FBIopeningUPP/aerix-core/hardware/core/production/bom.csv

Designator | Footprint | Quantity | Value | LCSC Part #
C1, C10, C11, C12, C13, C14, C15, C2, C20, C22, C24, C27, C28, C3, C30, C31, C33, C34, C35, C36, C37, C38, C4, C40, C41, C43, C44, C46, C47, C48, C5, C6, C7, C8, C9 | 0201 | 35 | 100nF
C16, C17, C18 | 0201 | 3 | 4.7uF
C19, C21, C23, C51, C52, C53, C54, C55, C56 | 0402 | 9 | 1uF
C25, C26, C29, C32 | 0402 | 4 | 2.2uF
C42, C45 | 0402 | 2 | 4.7uF
C49 | 0603 | 1 | 10uF
C50 | 0603 | 1 | 22uF
CARD1 | TF-SMD_TF-021B-H265 | 1 | TF-021B-H265 | C498185
CN1, CN2 | CONN-SMD_DF40C-80DS-0.4V-51 | 2 | DF40C-80DS-0.4V | C312960
FB1, FB2, FB3 | 0603 | 3 | 600
LED1, LED2 | 0402 | 2 | LED_0402
R1, R2, R3, R4, R5, R6, R7 | 0201 | 7 | 10k
R10, R11, R12, R8, R9 | 0201 | 5 | 47k
R13, R14 | 0201 | 2 | 1k
U1 | UFBGA-201_10x10mm_Layout15x15_P0.65mm | 1 | STM32H743IIKx
U10, U9 | TDFN-8_L3.0-W3.0-P0.65-BL-EP | 2 | TCAN1044AVDRBRQ1 | C3234119
U11, U12, U13 | X2SON-4_L1.0-W1.0-P0.65-TL-EP | 3 | TPS7A2033PDQNR | C2871641
U14 | USIP-10_L2.5-W2.0-P0.50-BL | 1 | TPSM82822SILR | C5219367
U2 | LGA-14_L3.0-W2.5-P0.50-TL | 1 | IIM-42653 | C30724128
U3 | LGA-14_L3.0-W2.5-P0.50-TL | 1 | ICM-45686 | C22459454
U4 | LGA-16_L4.5-W3.0-P0.50-BL | 1 | BMI088 | C194919
U5 | LGA-10_L2.0-W2.0-P0.50-BL | 1 | BMP390_C5124834 | C5124834
U6 | LGA-10_L2.0-W2.0-P0.50-TL_ICP-20100 | 1 | ICP-20100 | C5343527
U7 | WSON-8-1EP_8x6mm_P1.27mm_EP3.4x4.3mm | 1 | W25Q128JVE
X1 | CRYSTAL-SMD_4P-L3.2-W2.5-BL-1 | 1 | ABM8W-16.0000MHZ-8-D1X-T3 | C193746
