FBIopeningUPP/aerix-core/hardware/core/core.kicad_pcb

## KiCad design hardware/core/core.kicad_pcb (2026-11-12)

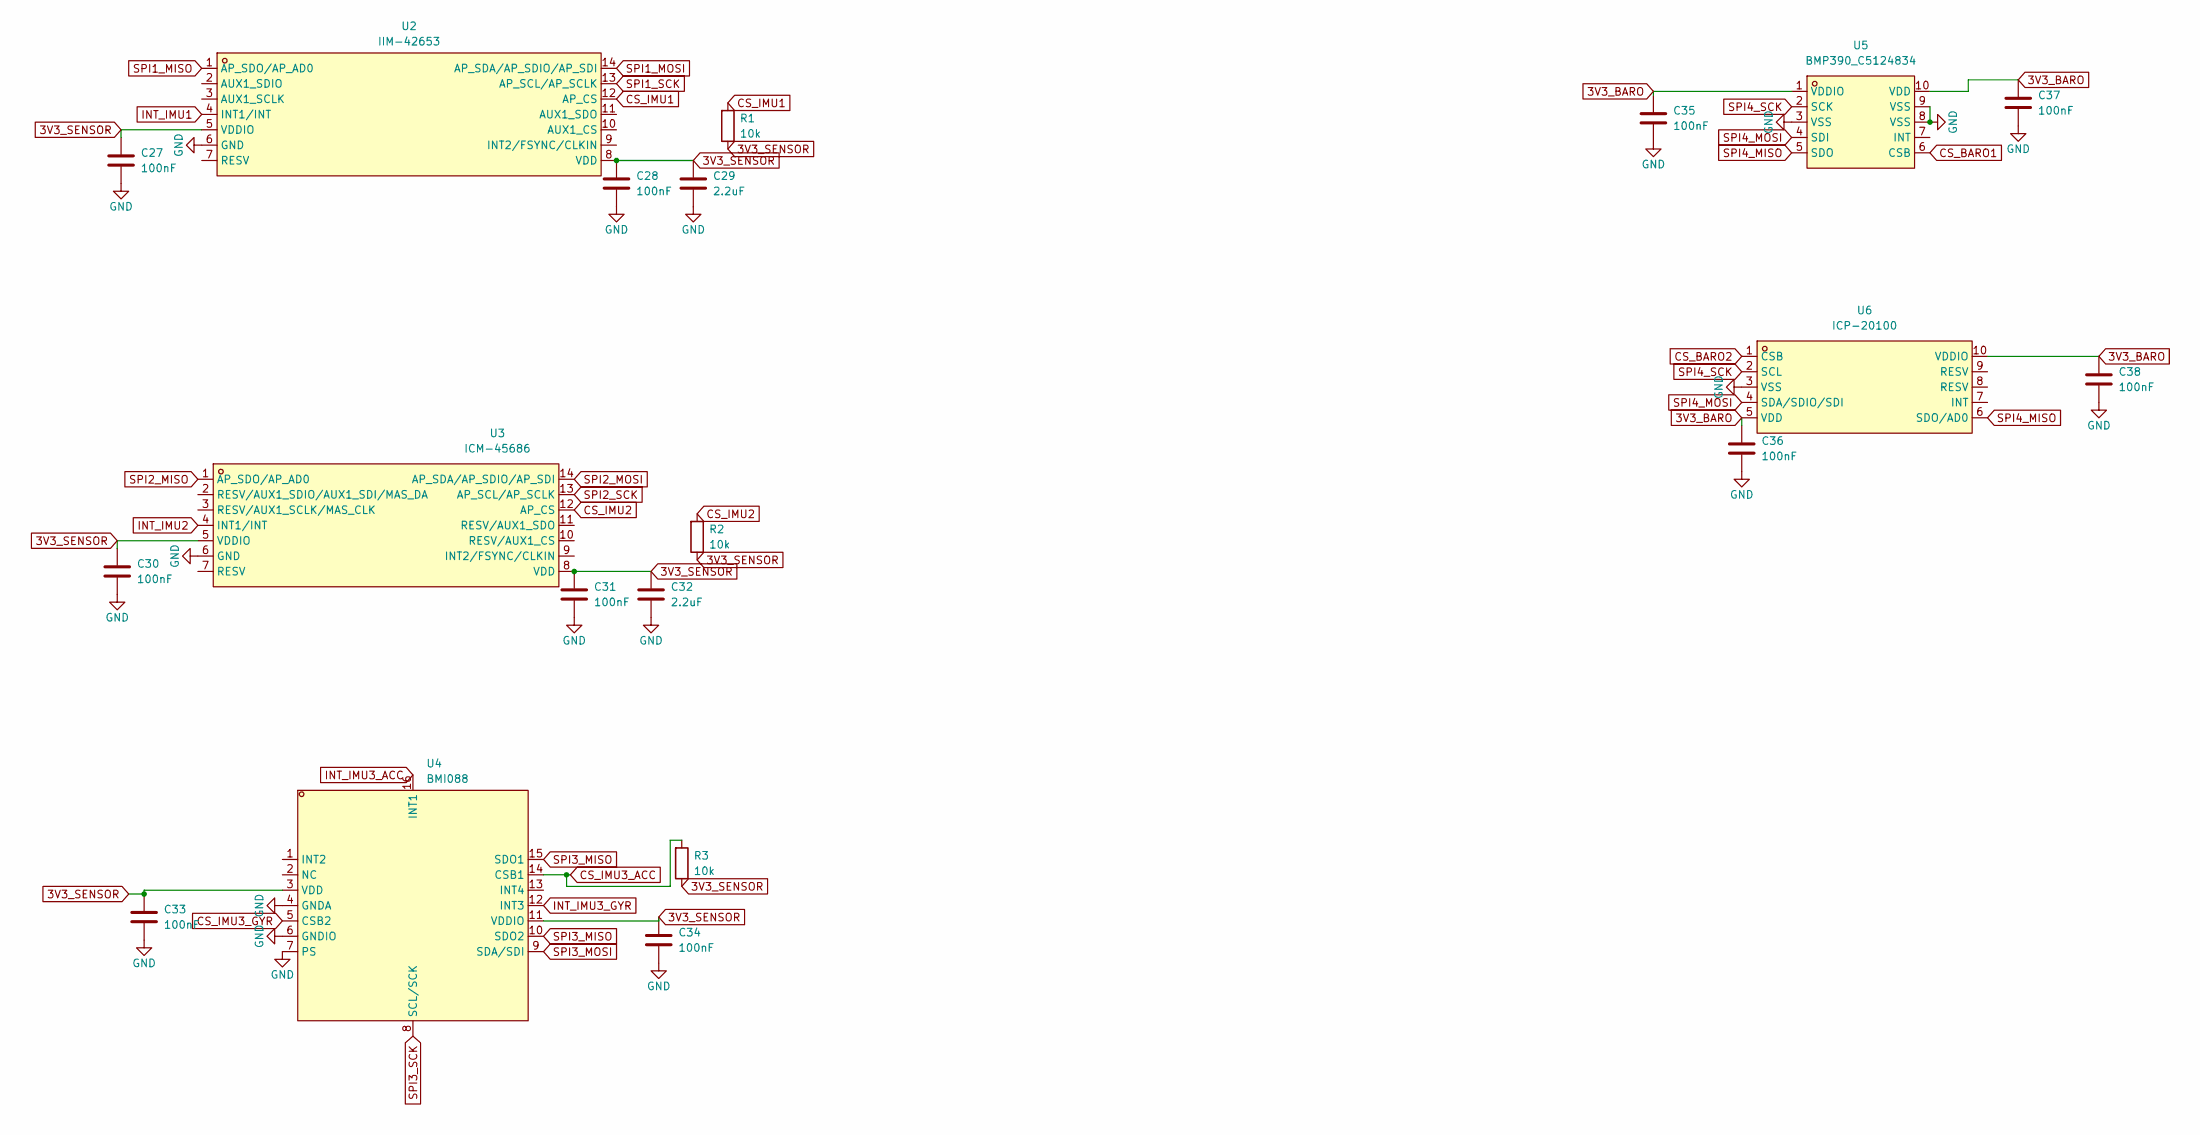
[picture p4: schematic sensor.kicad_sch]

Parts:
C27, C28, C30, C31, C33, C34, C35, C36, C37, C38: 100nF; C_0201_0603Metric
C29, C32: 2.2uF; C_0402_1005Metric
R1, R2, R3: 10k; R_0201_0603Metric
U2: IIM-42653; LGA-14_L3.0-W2.5-P0.50-TL; MPN IIM-42653; LCSC Part C30724128
U3: ICM-45686; LGA-14_L3.0-W2.5-P0.50-TL; MPN ICM-45686; LCSC Part C22459454
U4: BMI088; LGA-16_L4.5-W3.0-P0.50-BL; MPN BMI088; LCSC Part C194919
U5: BMP390_C5124834; LGA-10_L2.0-W2.0-P0.50-BL; MPN BMP390; LCSC Part C5124834
U6: ICP-20100; LGA-10_L2.0-W2.0-P0.50-TL_ICP-20100; MPN ICP-20100; LCSC Part C5343527

Connections:
3V3_BARO: C35.1, C36.1, C37.1, C38.1, U5.1 (VDDIO), U5.10 (VDD), U6.5 (VDD), U6.10 (VDDIO); also elsewhere on the board
3V3_SENSOR: C27.1, C28.1, C29.1, C30.1, C31.1, C32.1, C33.1, C34.1, R1.2, R2.2, R3.2, U2.5 (VDDIO), U2.8 (VDD), U3.5 (VDDIO), U3.8 (VDD), U4.3 (VDD), U4.11 (VDDIO); also elsewhere on the board
CS_BARO1: U5.6 (CSB); also elsewhere on the board
CS_BARO2: U6.1 (CSB); also elsewhere on the board
CS_IMU1: R1.1, U2.12 (AP_CS); also elsewhere on the board
CS_IMU2: R2.1, U3.12 (AP_CS); also elsewhere on the board
CS_IMU3_ACC: R3.1, U4.14 (CSB1); also elsewhere on the board
CS_IMU3_GYR: U4.5 (CSB2); also elsewhere on the board
GND: C27.2, C28.2, C29.2, C30.2, C31.2, C32.2, C33.2, C34.2, C35.2, C36.2, C37.2, C38.2, U2.6 (GND), U3.6 (GND), U4.4 (GNDA), U4.6 (GNDIO), U4.7 (PS), U5.3 (VSS), U5.8 (VSS), U5.9 (VSS), U6.3 (VSS); also elsewhere on the board
INT_IMU1: U2.4 (INT1/INT); also elsewhere on the board
INT_IMU2: U3.4 (INT1/INT); also elsewhere on the board
INT_IMU3_ACC: U4.16 (INT1); also elsewhere on the board
INT_IMU3_GYR: U4.12 (INT3); also elsewhere on the board
SPI1_MISO: U2.1 (AP_SDO/AP_AD0); also elsewhere on the board
SPI1_MOSI: U2.14 (AP_SDA/AP_SDIO/AP_SDI); also elsewhere on the board
SPI1_SCK: U2.13 (AP_SCL/AP_SCLK); also elsewhere on the board
SPI2_MISO: U3.1 (AP_SDO/AP_AD0); also elsewhere on the board
SPI2_MOSI: U3.14 (AP_SDA/AP_SDIO/AP_SDI); also elsewhere on the board
SPI2_SCK: U3.13 (AP_SCL/AP_SCLK); also elsewhere on the board
SPI3_MISO: U4.10 (SDO2), U4.15 (SDO1); also elsewhere on the board
SPI3_MOSI: U4.9 (SDA/SDI); also elsewhere on the board
SPI3_SCK: U4.8 (SCL/SCK); also elsewhere on the board
SPI4_MISO: U5.5 (SDO), U6.6 (SDO/AD0); also elsewhere on the board
SPI4_MOSI: U5.4 (SDI), U6.4 (SDA/SDIO/SDI); also elsewhere on the board
SPI4_SCK: U5.2 (SCK), U6.2 (SCL); also elsewhere on the board

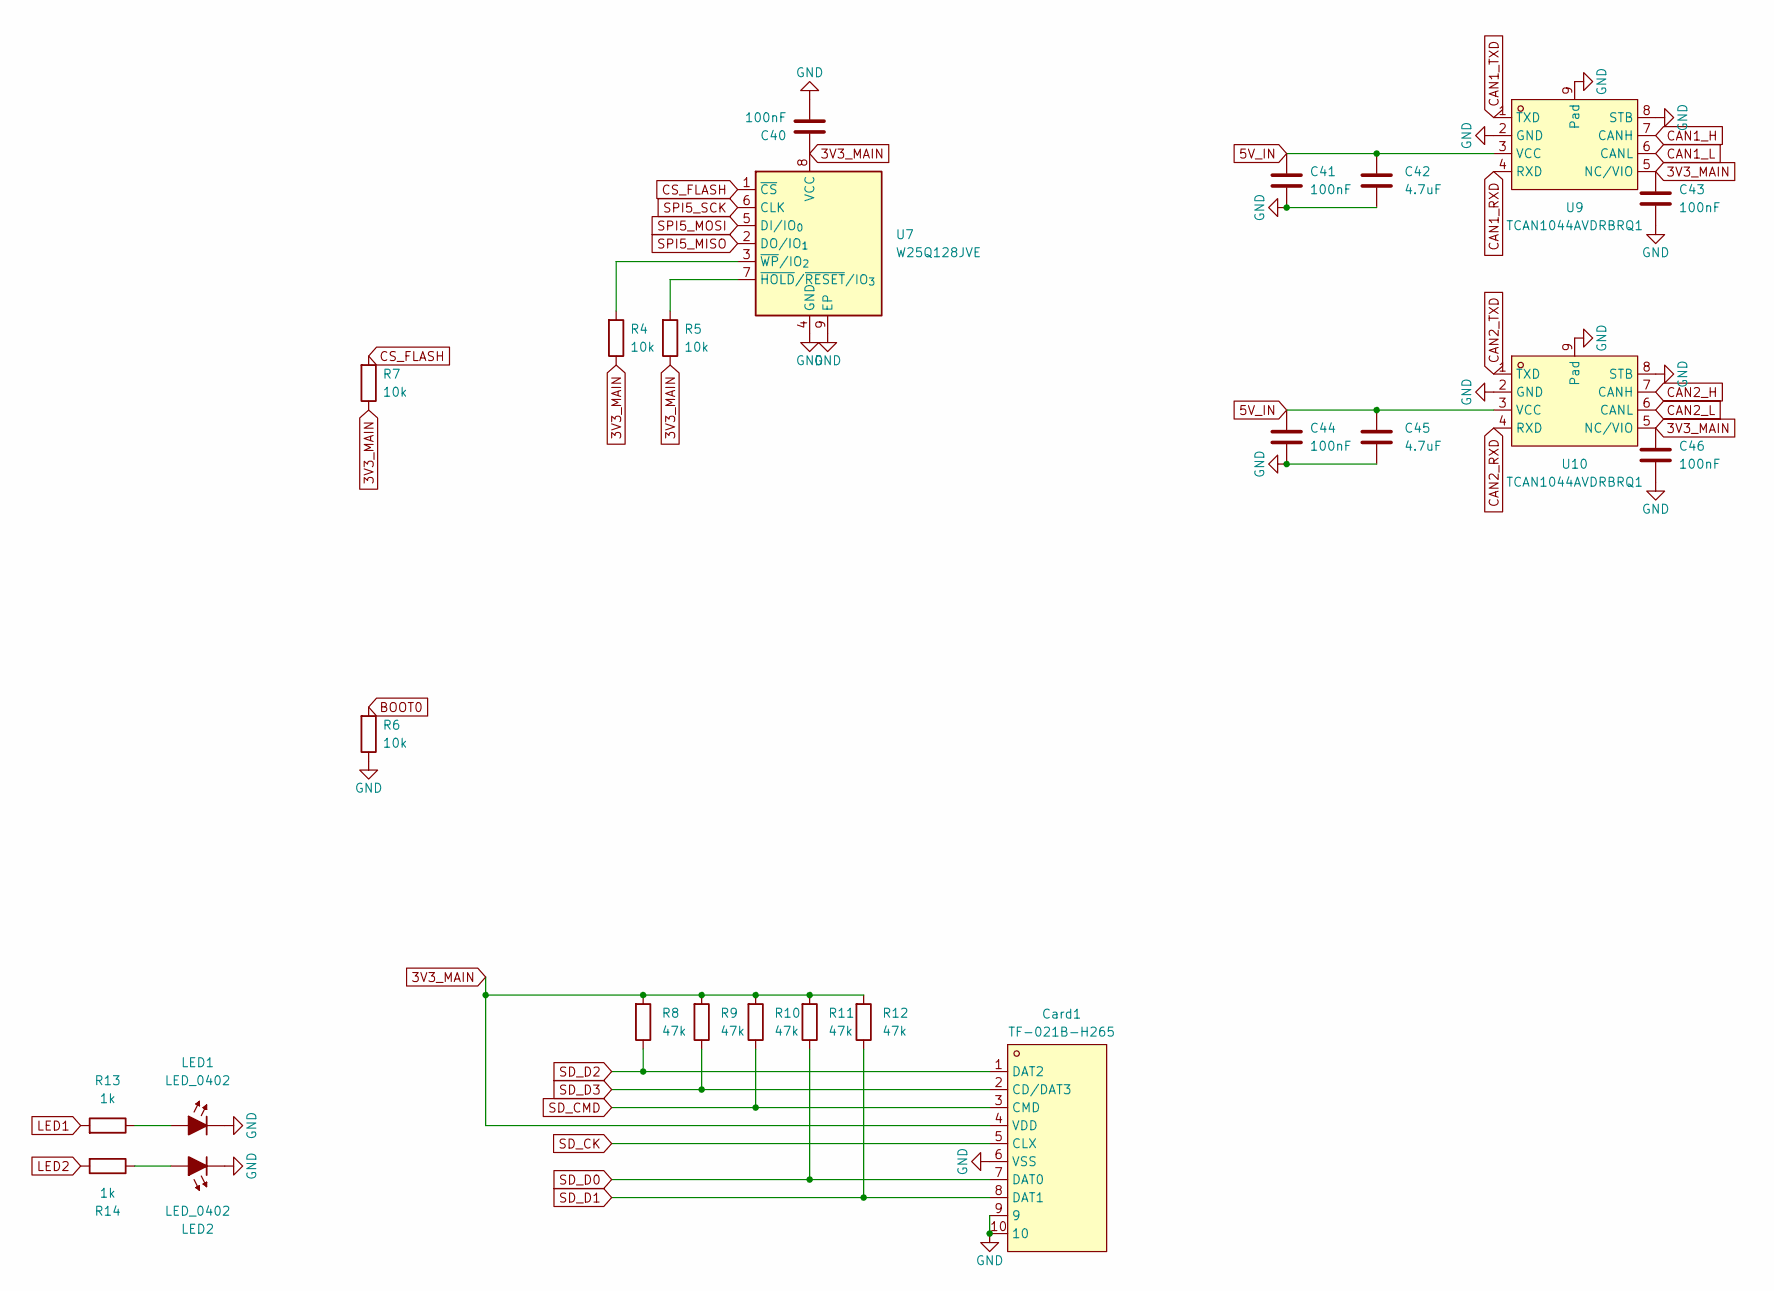
[picture p5: schematic etc.kicad_sch]

Parts:
C40, C41, C43, C44, C46: 100nF; C_0201_0603Metric
C42, C45: 4.7uF; C_0402_1005Metric
Card1: TF-021B-H265; TF-SMD_TF-021B-H265; MPN TF-021B-H265; LCSC Part C498185
LED1, LED2: LED_0402; LED_0402_1005Metric
R4, R5, R6, R7: 10k; R_0201_0603Metric
R8, R9, R10, R11, R12: 47k; R_0201_0603Metric
R13, R14: 1k; R_0201_0603Metric
U7: W25Q128JVE; WSON-8-1EP_8x6mm_P1.27mm_EP3.4x4.3mm
U9, U10: TCAN1044AVDRBRQ1; TDFN-8_L3.0-W3.0-P0.65-BL-EP; MPN TCAN1044AVDRBRQ1; LCSC Part C3234119

Connections:
3V3_MAIN: C40.1, C43.1, C46.1, Card1.4 (VDD), R4.2, R5.2, R7.2, R8.1, R9.1, R10.1, R11.1, R12.1, U7.8 (VCC), U9.5 (NC/VIO), U10.5 (NC/VIO); also elsewhere on the board
5V_IN: C41.1, C42.1, C44.1, C45.1, U9.3 (VCC), U10.3 (VCC); also elsewhere on the board
BOOT0: R6.1; also elsewhere on the board
CAN1_H: U9.7 (CANH); also elsewhere on the board
CAN1_L: U9.6 (CANL); also elsewhere on the board
CAN1_RXD: U9.4 (RXD); also elsewhere on the board
CAN1_TXD: U9.1 (TXD); also elsewhere on the board
CAN2_H: U10.7 (CANH); also elsewhere on the board
CAN2_L: U10.6 (CANL); also elsewhere on the board
CAN2_RXD: U10.4 (RXD); also elsewhere on the board
CAN2_TXD: U10.1 (TXD); also elsewhere on the board
CS_FLASH: R7.1, U7.1 (~CS); also elsewhere on the board
GND: C40.2, C41.2, C42.2, C43.2, C44.2, C45.2, C46.2, Card1.6 (VSS), Card1.9, Card1.10, LED1.1 (K), LED2.1 (K), R6.2, U7.4 (GND), U7.9 (EP), U9.2 (GND), U9.8 (STB), U9.9 (Pad), U10.2 (GND), U10.8 (STB), U10.9 (Pad); also elsewhere on the board
LED1: R13.1; also elsewhere on the board
LED2: R14.1; also elsewhere on the board
unnamed: LED1.2 (A), R13.2
unnamed: LED2.2 (A), R14.2
unnamed: R5.1, U7.7 (~HOLD/~RESET/IO_{3})
unnamed: R4.1, U7.3 (~WP/IO_{2})
SD_CK: Card1.5 (CLX); also elsewhere on the board
SD_CMD: Card1.3 (CMD), R10.2; also elsewhere on the board
SD_D0: Card1.7 (DAT0), R11.2; also elsewhere on the board
SD_D1: Card1.8 (DAT1), R12.2; also elsewhere on the board
SD_D2: Card1.1 (DAT2), R8.2; also elsewhere on the board
SD_D3: Card1.2 (CD/DAT3), R9.2; also elsewhere on the board
SPI5_MISO: U7.2 (DO/IO_{1}); also elsewhere on the board
SPI5_MOSI: U7.5 (DI/IO_{0}); also elsewhere on the board
SPI5_SCK: U7.6 (CLK); also elsewhere on the board

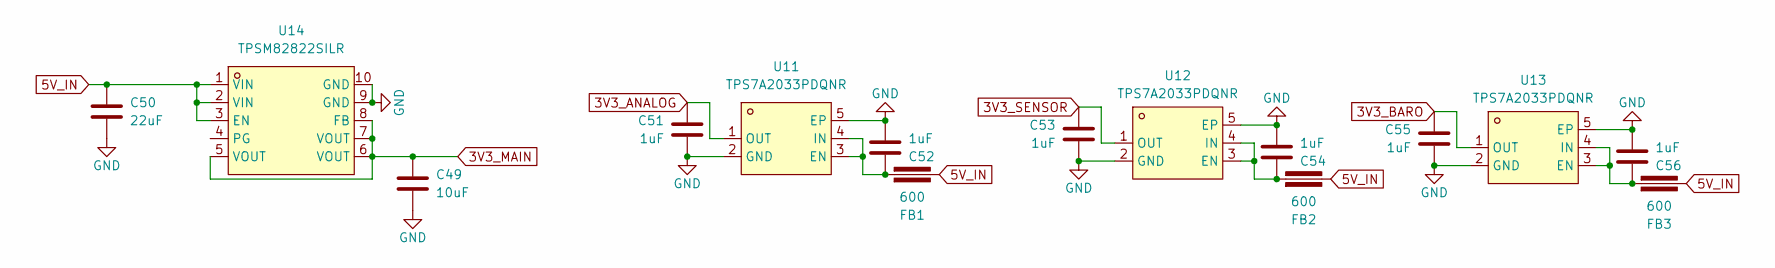
[picture p6: schematic power.kicad_sch]

Parts:
C49: 10uF; C_0603_1608Metric
C50: 22uF; C_0603_1608Metric
C51, C52, C53, C54, C55, C56: 1uF; C_0402_1005Metric
FB1, FB2, FB3: 600; Fuse_0603_1608Metric
U11, U12, U13: TPS7A2033PDQNR; X2SON-4_L1.0-W1.0-P0.65-TL-EP; MPN TPS7A2033PDQNR; LCSC Part C2871641
U14: TPSM82822SILR; USIP-10_L2.5-W2.0-P0.50-BL; MPN TPSM82822SILR; LCSC Part C5219367

Connections:
3V3_ANALOG: C51.2, U11.1 (OUT); also elsewhere on the board
3V3_BARO: C55.2, U13.1 (OUT); also elsewhere on the board
3V3_MAIN: C49.1, U14.5 (VOUT), U14.6 (VOUT), U14.7 (VOUT), U14.8 (FB); also elsewhere on the board
3V3_SENSOR: C53.2, U12.1 (OUT); also elsewhere on the board
5V_IN: C50.1, FB1.2, FB2.2, FB3.2, U14.1 (VIN), U14.2 (VIN), U14.3 (EN); also elsewhere on the board
GND: C49.2, C50.2, C51.1, C52.1, C53.1, C54.1, C55.1, C56.1, U11.2 (GND), U11.5 (EP), U12.2 (GND), U12.5 (EP), U13.2 (GND), U13.5 (EP), U14.9 (GND), U14.10 (GND); also elsewhere on the board
unnamed: C52.2, FB1.1, U11.3 (EN), U11.4 (IN)
unnamed: C54.2, FB2.1, U12.3 (EN), U12.4 (IN)
unnamed: C56.2, FB3.1, U13.3 (EN), U13.4 (IN)

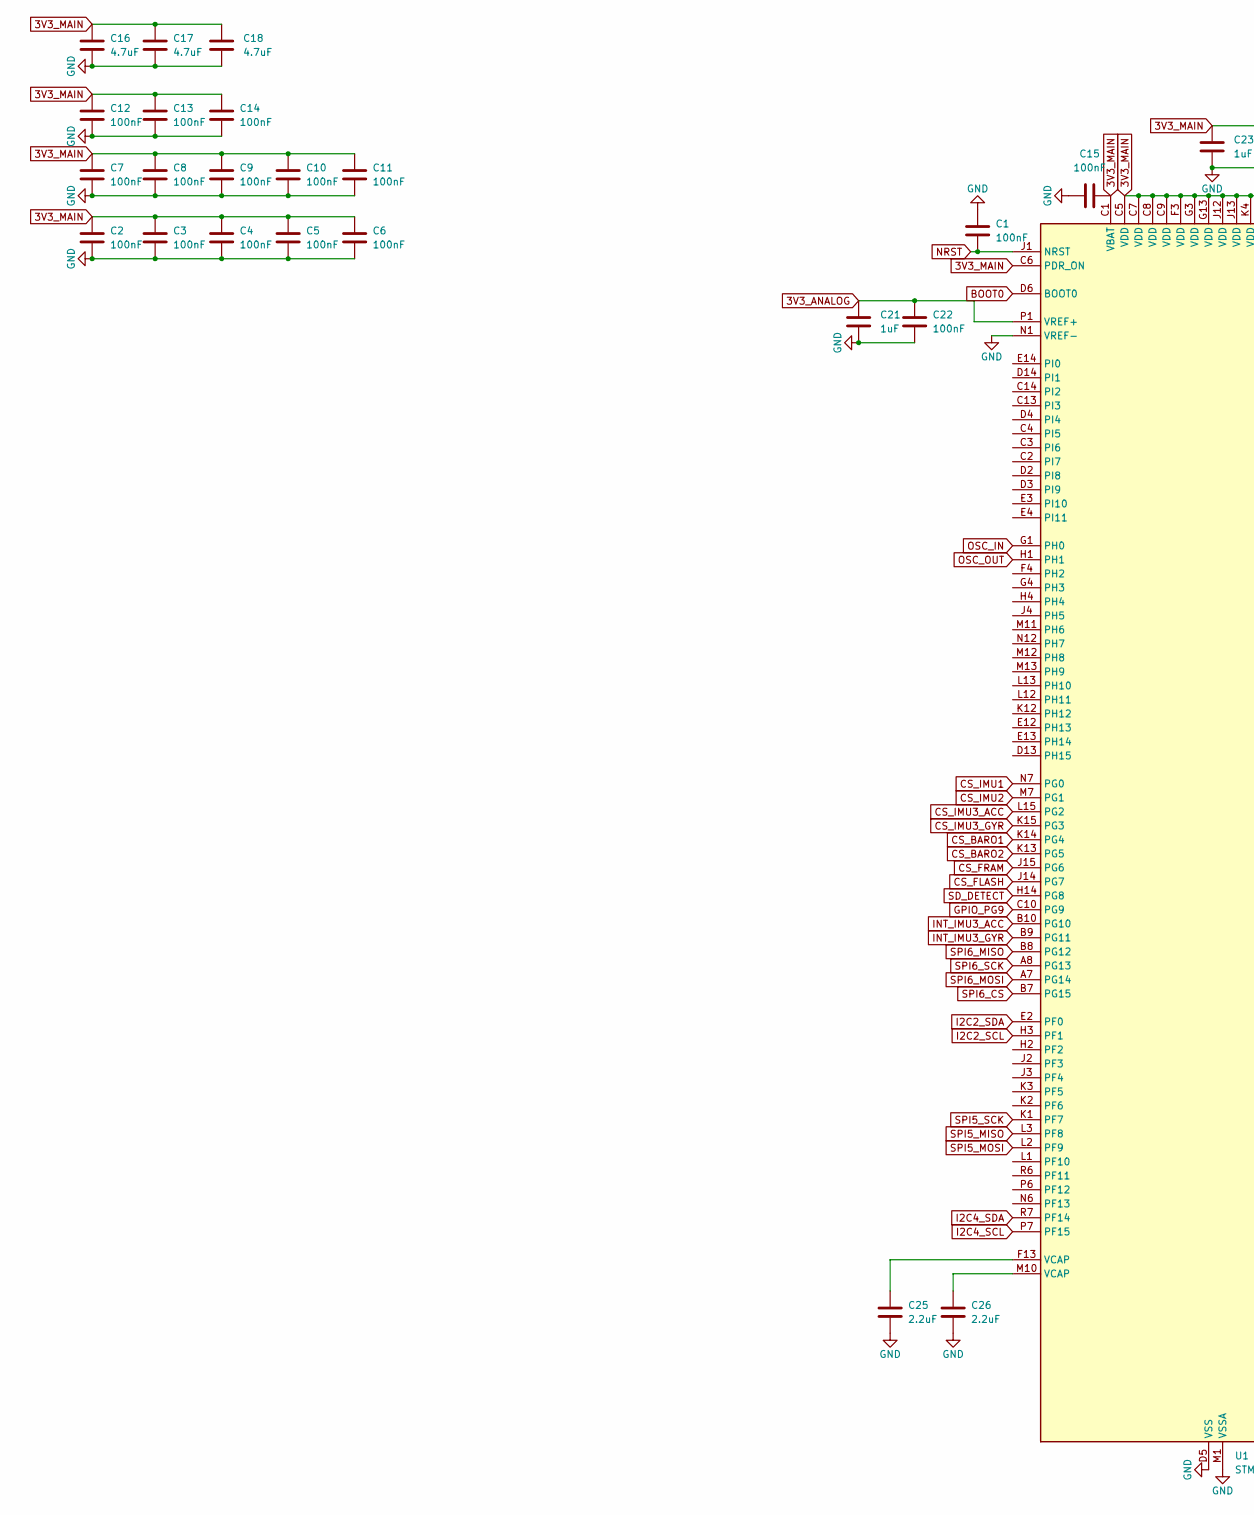
[picture p7: schematic mcu.kicad_sch, part in row 1, column 1]

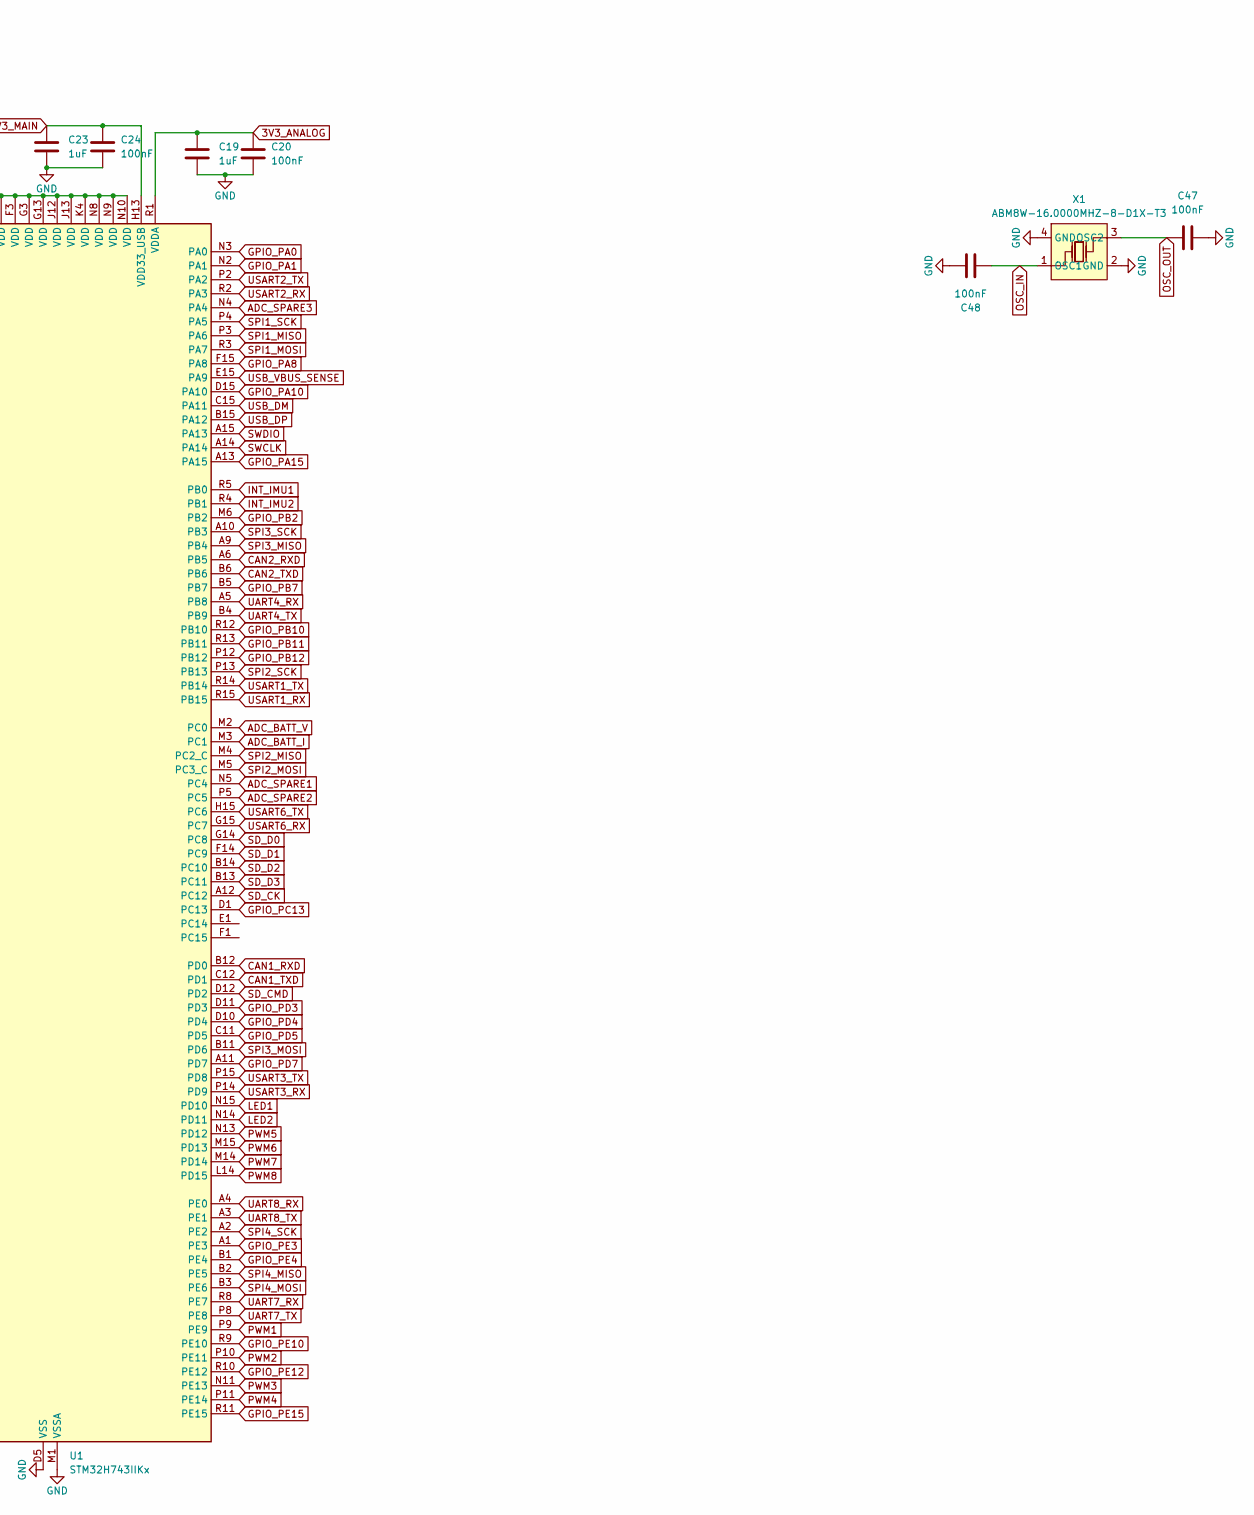
[picture p8: schematic mcu.kicad_sch, part in row 1, column 2]

Parts:
C1, C2, C3, C4, C5, C6, C7, C8, C9, C10, C11, C12, C13, C14, C15, C20, C22, C24, C47, C48: 100nF; C_0201_0603Metric
C16, C17, C18: 4.7uF; C_0201_0603Metric
C19, C21, C23: 1uF; C_0402_1005Metric
C25, C26: 2.2uF; C_0402_1005Metric
U1: STM32H743IIKx; UFBGA-201_10x10mm_Layout15x15_P0.65mm
X1: ABM8W-16.0000MHZ-8-D1X-T3; CRYSTAL-SMD_4P-L3.2-W2.5-BL-1; MPN ABM8W-16.0000MHZ-8-D1X-T3; LCSC Part C193746

Connections:
3V3_ANALOG: C19.1, C20.1, C21.1, C22.1, U1.P1 (VREF+), U1.R1 (VDDA); also elsewhere on the board
3V3_MAIN: C2.1, C3.1, C4.1, C5.1, C6.1, C7.1, C8.1, C9.1, C10.1, C11.1, C12.1, C13.1, C14.1, C15.2, C16.1, C17.1, C18.1, C23.1, C24.1, U1.C1 (VBAT), U1.C5 (VDD), U1.C6 (PDR_ON), U1.C7 (VDD), U1.C8 (VDD), U1.C9 (VDD), U1.F3 (VDD), U1.G3 (VDD), U1.G13 (VDD), U1.H13 (VDD33_USB), U1.J12 (VDD), U1.J13 (VDD), U1.K4 (VDD), U1.N8 (VDD), U1.N9 (VDD), U1.N10 (VDD); also elsewhere on the board
ADC_BATT_I: U1.M3 (PC1); also elsewhere on the board
ADC_BATT_V: U1.M2 (PC0); also elsewhere on the board
ADC_SPARE1: U1.N5 (PC4); also elsewhere on the board
ADC_SPARE2: U1.P5 (PC5); also elsewhere on the board
ADC_SPARE3: U1.N4 (PA4); also elsewhere on the board
BOOT0: U1.D6 (BOOT0); also elsewhere on the board
CAN1_RXD: U1.B12 (PD0); also elsewhere on the board
CAN1_TXD: U1.C12 (PD1); also elsewhere on the board
CAN2_RXD: U1.A6 (PB5); also elsewhere on the board
CAN2_TXD: U1.B6; also elsewhere on the board
CS_BARO1: U1.K14 (PG4); also elsewhere on the board
CS_BARO2: U1.K13 (PG5); also elsewhere on the board
CS_FLASH: U1.J14 (PG7); also elsewhere on the board
CS_FRAM: U1.J15 (PG6)
CS_IMU1: U1.N7 (PG0); also elsewhere on the board
CS_IMU2: U1.M7 (PG1); also elsewhere on the board
CS_IMU3_ACC: U1.L15 (PG2); also elsewhere on the board
CS_IMU3_GYR: U1.K15 (PG3); also elsewhere on the board
GND: C1.1, C2.2, C3.2, C4.2, C5.2, C6.2, C7.2, C8.2, C9.2, C10.2, C11.2, C12.2, C13.2, C14.2, C15.1, C16.2, C17.2, C18.2, C19.2, C20.2, C21.2, C22.2, C23.2, C24.2, C25.2, C26.2, C47.2, C48.2, U1.D5 (VSS), U1.D7 (VSS), U1.D8 (VSS), U1.D9 (VSS), U1.F2 (VSS), U1.F6 (VSS), U1.F7 (VSS), U1.F8 (VSS), U1.F9 (VSS), U1.F10 (VSS), U1.F12 (VSS), U1.G2 (VSS), U1.G6 (VSS), U1.G7 (VSS), U1.G8 (VSS), U1.G9 (VSS), U1.G10 (VSS), U1.G12 (VSS), U1.H6 (VSS), U1.H7 (VSS), U1.H8 (VSS), U1.H9 (VSS), U1.H10 (VSS), U1.H12 (VSS), U1.J6 (VSS), U1.J7 (VSS), U1.J8 (VSS), U1.J9 (VSS), U1.J10 (VSS), U1.K6 (VSS), U1.K7 (VSS), U1.K8 (VSS), U1.K9 (VSS), U1.K10 (VSS), U1.L4 (VSS), U1.M1 (VSSA), U1.M8 (VSS), U1.M9 (VSS), U1.N1 (VREF-), X1.2 (GND), X1.4 (GND); also elsewhere on the board
GPIO_PA0: U1.N3 (PA0); also elsewhere on the board
GPIO_PA1: U1.N2 (PA1); also elsewhere on the board
GPIO_PA8: U1.F15 (PA8); also elsewhere on the board
GPIO_PA10: U1.D15 (PA10); also elsewhere on the board
GPIO_PA15: U1.A13 (PA15); also elsewhere on the board
GPIO_PB2: U1.M6 (PB2); also elsewhere on the board
GPIO_PB7: U1.B5 (PB7); also elsewhere on the board
GPIO_PB10: U1.R12 (PB10); also elsewhere on the board
GPIO_PB11: U1.R13 (PB11); also elsewhere on the board
GPIO_PB12: U1.P12 (PB12); also elsewhere on the board
GPIO_PC13: U1.D1 (PC13); also elsewhere on the board
GPIO_PD3: U1.D11 (PD3); also elsewhere on the board
GPIO_PD4: U1.D10 (PD4); also elsewhere on the board
GPIO_PD5: U1.C11 (PD5); also elsewhere on the board
GPIO_PD7: U1.A11 (PD7); also elsewhere on the board
GPIO_PE3: U1.A1 (PE3); also elsewhere on the board
GPIO_PE4: U1.B1 (PE4); also elsewhere on the board
GPIO_PE10: U1.R9 (PE10); also elsewhere on the board
GPIO_PE12: U1.R10 (PE12); also elsewhere on the board
GPIO_PE15: U1.R11 (PE15); also elsewhere on the board
GPIO_PG9: U1.C10 (PG9); also elsewhere on the board
I2C2_SCL: U1.H3 (PF1); also elsewhere on the board
I2C2_SDA: U1.E2 (PF0); also elsewhere on the board
I2C4_SCL: U1.P7 (PF15); also elsewhere on the board
I2C4_SDA: U1.R7 (PF14); also elsewhere on the board
INT_IMU1: U1.R5 (PB0); also elsewhere on the board
INT_IMU2: U1.R4 (PB1); also elsewhere on the board
INT_IMU3_ACC: U1.B10 (PG10); also elsewhere on the board
INT_IMU3_GYR: U1.B9 (PG11); also elsewhere on the board
LED1: U1.N15 (PD10); also elsewhere on the board
LED2: U1.N14 (PD11); also elsewhere on the board
NRST: C1.2, U1.J1 (NRST); also elsewhere on the board
unnamed: C25.1, U1.F13 (VCAP)
unnamed: C26.1, U1.M10 (VCAP)
OSC_IN: C48.1, U1.G1 (PH0), X1.1 (OSC1)
OSC_OUT: C47.1, U1.H1, X1.3 (OSC2)
PWM1: U1.P9 (PE9); also elsewhere on the board
PWM2: U1.P10 (PE11); also elsewhere on the board
PWM3: U1.N11 (PE13); also elsewhere on the board
PWM4: U1.P11 (PE14); also elsewhere on the board
PWM5: U1.N13 (PD12); also elsewhere on the board
PWM6: U1.M15 (PD13); also elsewhere on the board
PWM7: U1.M14 (PD14); also elsewhere on the board
PWM8: U1.L14 (PD15); also elsewhere on the board
SD_CK: U1.A12 (PC12); also elsewhere on the board
SD_CMD: U1.D12 (PD2); also elsewhere on the board
SD_D0: U1.G14 (PC8); also elsewhere on the board
SD_D1: U1.F14 (PC9); also elsewhere on the board
SD_D2: U1.B14 (PC10); also elsewhere on the board
SD_D3: U1.B13 (PC11); also elsewhere on the board
SD_DETECT: U1.H14 (PG8)
SPI1_MISO: U1.P3 (PA6); also elsewhere on the board
SPI1_MOSI: U1.R3 (PA7); also elsewhere on the board
SPI1_SCK: U1.P4 (PA5); also elsewhere on the board
SPI2_MISO: U1.M4 (PC2_C); also elsewhere on the board
SPI2_MOSI: U1.M5 (PC3_C); also elsewhere on the board
SPI2_SCK: U1.P13 (PB13); also elsewhere on the board
SPI3_MISO: U1.A9 (PB4); also elsewhere on the board
SPI3_MOSI: U1.B11 (PD6); also elsewhere on the board
SPI3_SCK: U1.A10 (PB3); also elsewhere on the board
SPI4_MISO: U1.B2 (PE5); also elsewhere on the board
SPI4_MOSI: U1.B3 (PE6); also elsewhere on the board
SPI4_SCK: U1.A2 (PE2); also elsewhere on the board
SPI5_MISO: U1.L3 (PF8); also elsewhere on the board
SPI5_MOSI: U1.L2 (PF9); also elsewhere on the board
SPI5_SCK: U1.K1 (PF7); also elsewhere on the board
SPI6_CS: U1.B7 (PG15); also elsewhere on the board
SPI6_MISO: U1.B8 (PG12); also elsewhere on the board
SPI6_MOSI: U1.A7 (PG14); also elsewhere on the board
SPI6_SCK: U1.A8 (PG13); also elsewhere on the board
SWCLK: U1.A14; also elsewhere on the board
SWDIO: U1.A15 (PA13); also elsewhere on the board
UART4_RX: U1.A5 (PB8); also elsewhere on the board
UART4_TX: U1.B4 (PB9); also elsewhere on the board
UART7_RX: U1.R8 (PE7); also elsewhere on the board
UART7_TX: U1.P8 (PE8); also elsewhere on the board
UART8_RX: U1.A4 (PE0); also elsewhere on the board
UART8_TX: U1.A3 (PE1); also elsewhere on the board
USART1_RX: U1.R15 (PB15); also elsewhere on the board
USART1_TX: U1.R14 (PB14); also elsewhere on the board
USART2_RX: U1.R2 (PA3); also elsewhere on the board
USART2_TX: U1.P2 (PA2); also elsewhere on the board
USART3_RX: U1.P14 (PD9); also elsewhere on the board
USART3_TX: U1.P15 (PD8); also elsewhere on the board
USART6_RX: U1.G15 (PC7); also elsewhere on the board
USART6_TX: U1.H15 (PC6); also elsewhere on the board
USB_DM: U1.C15 (PA11); also elsewhere on the board
USB_DP: U1.B15 (PA12); also elsewhere on the board
USB_VBUS_SENSE: U1.E15 (PA9); also elsewhere on the board

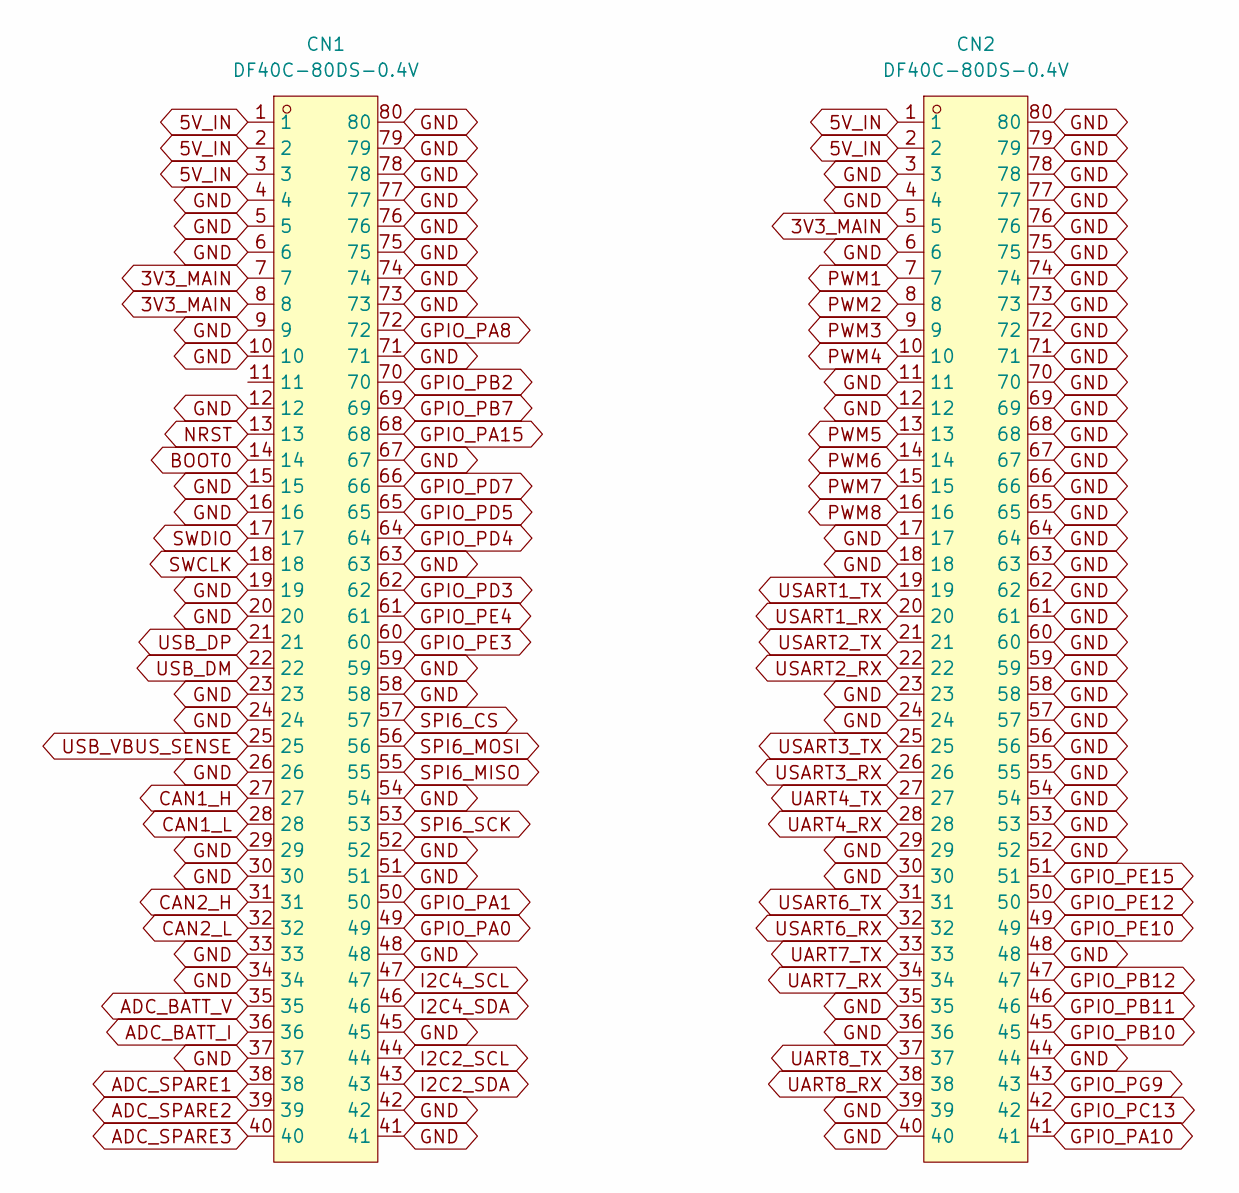
[picture p9: schematic footprint.kicad_sch]

Parts:
CN1, CN2: DF40C-80DS-0.4V; CONN-SMD_DF40C-80DS-0.4V-51; MPN DF40C-80DS-0.4V(51); LCSC Part C312960

Connections:
3V3_MAIN: CN1.7, CN1.8, CN2.5; also elsewhere on the board
5V_IN: CN1.1, CN1.2, CN1.3, CN2.1, CN2.2; also elsewhere on the board
ADC_BATT_I: CN1.36; also elsewhere on the board
ADC_BATT_V: CN1.35; also elsewhere on the board
ADC_SPARE1: CN1.38; also elsewhere on the board
ADC_SPARE2: CN1.39; also elsewhere on the board
ADC_SPARE3: CN1.40; also elsewhere on the board
BOOT0: CN1.14; also elsewhere on the board
CAN1_H: CN1.27; also elsewhere on the board
CAN1_L: CN1.28; also elsewhere on the board
CAN2_H: CN1.31; also elsewhere on the board
CAN2_L: CN1.32; also elsewhere on the board
GND: CN1.4, CN1.5, CN1.6, CN1.9, CN1.10, CN1.12, CN1.15, CN1.16, CN1.19, CN1.20, CN1.23, CN1.24, CN1.26, CN1.29, CN1.30, CN1.33, CN1.34, CN1.37, CN1.41, CN1.42, CN1.45, CN1.48, CN1.51, CN1.52, CN1.54, CN1.58, CN1.59, CN1.63, CN1.67, CN1.71, CN1.73, CN1.74, CN1.75, CN1.76, CN1.77, CN1.78, CN1.79, CN1.80, CN2.3, CN2.4, CN2.6, CN2.11, CN2.12, CN2.17, CN2.18, CN2.23, CN2.24, CN2.29, CN2.30, CN2.35, CN2.36, CN2.39, CN2.40, CN2.44, CN2.48, CN2.52, CN2.53, CN2.54, CN2.55, CN2.56, CN2.57, CN2.58, CN2.59, CN2.60, CN2.61, CN2.62, CN2.63, CN2.64, CN2.65, CN2.66, CN2.67, CN2.68, CN2.69, CN2.70, CN2.71, CN2.72, CN2.73, CN2.74, CN2.75, CN2.76, CN2.77, CN2.78, CN2.79, CN2.80; also elsewhere on the board
GPIO_PA0: CN1.49; also elsewhere on the board
GPIO_PA1: CN1.50; also elsewhere on the board
GPIO_PA8: CN1.72; also elsewhere on the board
GPIO_PA10: CN2.41; also elsewhere on the board
GPIO_PA15: CN1.68; also elsewhere on the board
GPIO_PB2: CN1.70; also elsewhere on the board
GPIO_PB7: CN1.69; also elsewhere on the board
GPIO_PB10: CN2.45; also elsewhere on the board
GPIO_PB11: CN2.46; also elsewhere on the board
GPIO_PB12: CN2.47; also elsewhere on the board
GPIO_PC13: CN2.42; also elsewhere on the board
GPIO_PD3: CN1.62; also elsewhere on the board
GPIO_PD4: CN1.64; also elsewhere on the board
GPIO_PD5: CN1.65; also elsewhere on the board
GPIO_PD7: CN1.66; also elsewhere on the board
GPIO_PE3: CN1.60; also elsewhere on the board
GPIO_PE4: CN1.61; also elsewhere on the board
GPIO_PE10: CN2.49; also elsewhere on the board
GPIO_PE12: CN2.50; also elsewhere on the board
GPIO_PE15: CN2.51; also elsewhere on the board
GPIO_PG9: CN2.43; also elsewhere on the board
I2C2_SCL: CN1.44; also elsewhere on the board
I2C2_SDA: CN1.43; also elsewhere on the board
I2C4_SCL: CN1.47; also elsewhere on the board
I2C4_SDA: CN1.46; also elsewhere on the board
NRST: CN1.13; also elsewhere on the board
PWM1: CN2.7; also elsewhere on the board
PWM2: CN2.8; also elsewhere on the board
PWM3: CN2.9; also elsewhere on the board
PWM4: CN2.10; also elsewhere on the board
PWM5: CN2.13; also elsewhere on the board
PWM6: CN2.14; also elsewhere on the board
PWM7: CN2.15; also elsewhere on the board
PWM8: CN2.16; also elsewhere on the board
SPI6_CS: CN1.57; also elsewhere on the board
SPI6_MISO: CN1.55; also elsewhere on the board
SPI6_MOSI: CN1.56; also elsewhere on the board
SPI6_SCK: CN1.53; also elsewhere on the board
SWCLK: CN1.18; also elsewhere on the board
SWDIO: CN1.17; also elsewhere on the board
UART4_RX: CN2.28; also elsewhere on the board
UART4_TX: CN2.27; also elsewhere on the board
UART7_RX: CN2.34; also elsewhere on the board
UART7_TX: CN2.33; also elsewhere on the board
UART8_RX: CN2.38; also elsewhere on the board
UART8_TX: CN2.37; also elsewhere on the board
USART1_RX: CN2.20; also elsewhere on the board
USART1_TX: CN2.19; also elsewhere on the board
USART2_RX: CN2.22; also elsewhere on the board
USART2_TX: CN2.21; also elsewhere on the board
USART3_RX: CN2.26; also elsewhere on the board
USART3_TX: CN2.25; also elsewhere on the board
USART6_RX: CN2.32; also elsewhere on the board
USART6_TX: CN2.31; also elsewhere on the board
USB_DM: CN1.22; also elsewhere on the board
USB_DP: CN1.21; also elsewhere on the board
USB_VBUS_SENSE: CN1.25; also elsewhere on the board

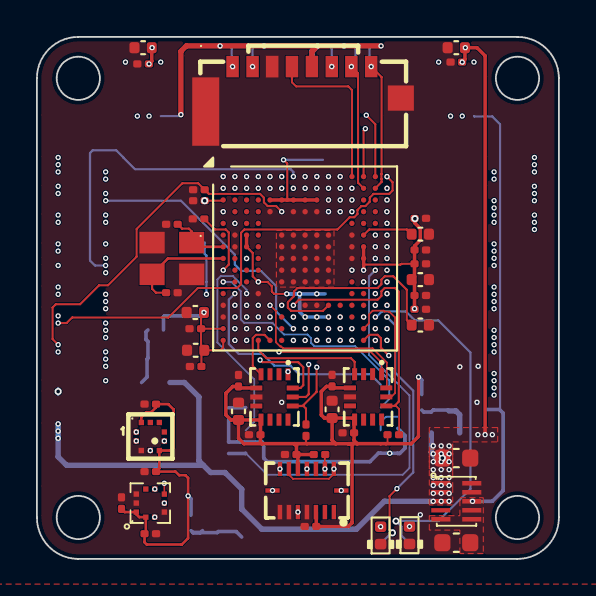
[picture p10: board core.kicad_pcb from above]

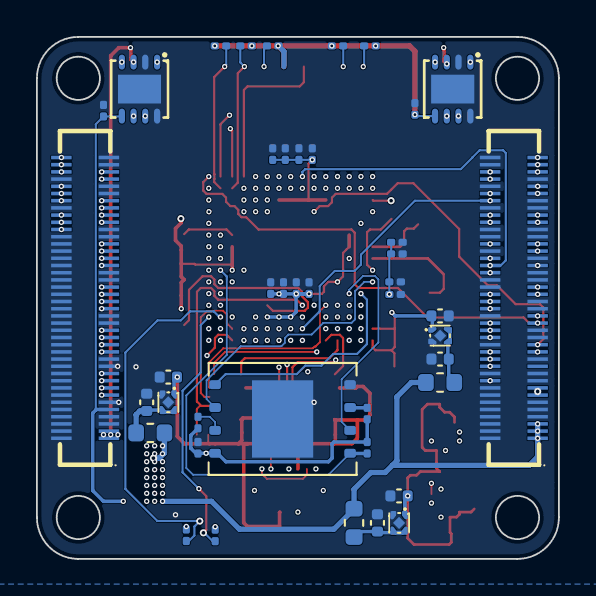
[picture p11: board core.kicad_pcb from below]

Board: 8 copper layers, 29.0 x 29.0 mm, 91 parts (42 on the bottom side), 122 nets.
