FBIopeningUPP/aerix-core/(commit log)

2026-11-04 shit hppened lot of thist
    [core.kicad_pcb, core.kicad_sch, etc.kicad_sch, footprint.kicad_sch, mcu.kicad_sch, power.kicad_sch, sensor.kicad_sch]
2026-11-04 asked ai to make gitignore and all
    [core.kicad_pcb, etc.kicad_sch, footprint.kicad_sch, mcu.kicad_sch, power.kicad_sch, sensor.kicad_sch]
2026-11-06 something anything typ shit cheetah hi kede
    [core.kicad_pcb]
2026-11-06 Add global labels for power and sensor connections
    - Introduced a new global label "5V_IN" in the power schematic to replace "5V_VIN" for clarity.
    - Added a ground symbol with a global label "GND" in the power schematic.
    - Added multiple instances of the global label "3V3_SENSOR" in the sensor schematic at various locations to improve connectivity and readability.
    [core.kicad_pcb, etc.kicad_sch, mcu.kicad_sch, power.kicad_sch, sensor.kicad_sch]
2026-11-12 done and dusted
    [bom.csv, core.kicad_pcb, designators.csv, positions.csv]
2026-11-12 more than enoguh ig
    [core.kicad_pcb]
